kuba-kedzior/Rocketry-GPS-Tracker/Hardware/SCH_Schematic1_1-P1_2026-02-14.png

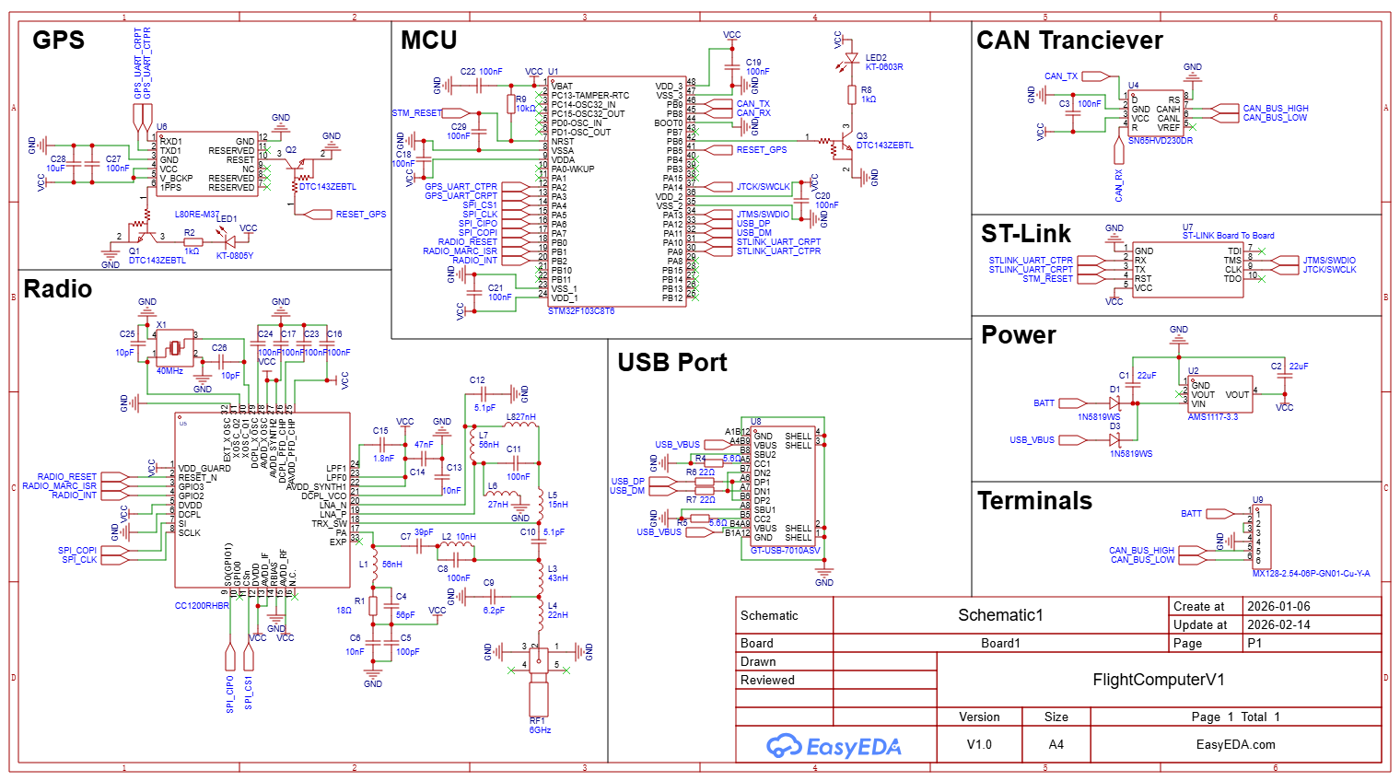
Hardware/SCH_Schematic1_1-P1_2026-02-14.png
