kuba-kedzior/Rocketry-GPS-Tracker/Hardware/BOM_Board1_PCB1_2026-04-08.csv

No. | Quantity | Comment | Designator | Footprint | Value | Manufacturer Part | Manufacturer | Supplier Part | Supplier | Primary Category | Secondary Category | JLCPCB Price | JLCPCB Stock | Name | Device
1 | 3 | 22uF | C1,C2,C30 | C0805 | 22uF | CL21A226MAQNNNE | SAMSUNG(三星) | C45783 | LCSC | Capacitors | Multilayer Ceramic Capacitors MLCC - SMD/SMT |  |  | 22uF | CL21A226MAQNNNE
2 | 10 | 100nF | C3,C18,C19,C20,C21,C22,C27,C29,C31,C32 | C0402 | 100nF | TCC0402X5R104M250AT | CCTC(三环) | C359190 | LCSC |  |  |  |  | 100nF | TCC0402X5R104M250AT
3 | 3 | 10uF | C28,C33,C34 | C0603 | 10uF | CL10A106MQ8NNNC | SAMSUNG(三星) | C1691 | LCSC |  |  |  |  | 10uF | CL10A106MQ8NNNC
4 | 2 | 1N5819WS | D1,D3 | SOD-323_L1.8-W1.3-LS2.5-RD |  | 1N5819WS | Hottech(合科泰) | C191023 | LCSC | Diodes | Schottky Diodes |  |  | 1N5819WS | 1N5819WS_C191023
5 | 1 | KT-0805Y | LED1 | LED0805-R-RD |  | KT-0805Y | KENTO | C2296 | LCSC | Optoelectronics | LED Indication - Discrete |  |  | KT-0805Y | KT-0805Y
6 | 1 | KT-0603R | LED2 | LED0603-RD |  | KT-0603R | KENTO | C2286 | LCSC | Optoelectronics | LED Indication - Discrete |  |  | KT-0603R | KT-0603R
7 | 1 | DTC143ZEBTL | Q1 | SC-89-3_L1.6-W0.9-P1.00-LS1.6-BR |  | DTC143ZEBTL | ROHM(罗姆) | C308696 | LCSC | Transistors/Thyristors | Digital Transistors |  |  | DTC143ZEBTL | DTC143ZEBTL
8 | 2 | 1kΩ | R2,R8 | R1206 | 1kΩ | 1206W4J0102T5E | UNI-ROYAL(厚声) | C1469 | LCSC |  |  |  |  | 1kΩ | 1206W4J0102T5E_C1469
9 | 2 | 5.1kΩ | R4,R5 | R0603 | 5.1kΩ | 0603WAF5101T5E | UNI-ROYAL(厚声) | C23186 | LCSC |  |  |  |  |  | 0603WAF5101T5E
10 | 2 | 22Ω | R6,R7 | R0603 | 22Ω | 0603WAJ0220T5E | UNI-ROYAL(厚声) | C1203 | LCSC |  |  |  |  | 22Ω | 0603WAJ0220T5E
11 | 1 | 10kΩ | R9 | R0402 | 10kΩ | 0402WGF1002TCE | UNI-ROYAL(厚声) | C25744 | LCSC |  |  |  |  | 10kΩ | 0402WGF1002TCE
12 | 1 | 6GHz | RF1 | SMA-SMD_HYCW12-SMAW0863-1365B | 6GHz | HYCW12-SMAW0863-1365B | 华宇创 | C5301850 | LCSC | Connectors | Coaxial Connectors (RF) |  |  | 6GHz | HYCW12-SMAW0863-1365B
13 | 1 | STM32F103C8T6 | U1 | LQFP-48_L7.0-W7.0-P0.50-LS9.0-BL |  | STM32F103C8T6 | ST(意法半导体) | C8734 | LCSC | Embedded Processors & Controllers | Microcontrollers (MCU/MPU/SOC) |  |  | STM32F103C8T6 | STM32F103C8T6
14 | 1 | AMS1117-3.3 | U2 | SOT-223-3_L6.5-W3.4-P2.30-LS7.0-BR |  | AMS1117-3.3 | AMS | C6186 | LCSC | Power Management (PMIC) | Voltage Regulators - Linear, Low Drop Out (LDO) Regulators |  |  | AMS1117-3.3 | AMS1117-3.3_C6186
15 | 1 | SN65HVD230DR | U4 | SOIC-8_L4.9-W3.9-P1.27-LS6.0-BL |  | SN65HVD230DR | TI(德州仪器) | C12084 | LCSC | Interface | CAN Transceivers |  |  | SN65HVD230DR | SN65HVD230DR
16 | 1 | L80RE-M37 | U6 | GPSM-SMD_12P-L16.0-W16.0-P2.54-BL |  | L80RE-M37 | Quectel(移远) | C3029061 | LCSC | IoT/Communication Modules | GNSS Modules |  |  | L80RE-M37 | L80RE-M37
17 | 1 | ST-LINK Board To Board | U7 | ST-LINK BOARD TO BOARD |  |  |  |  |  |  |  |  |  | ST-LINK Board To Board | ST-LINK Board To Board
18 | 1 | GT-USB-7010ASV | U8 | USB-C-SMD_G-SWITCH_GT-USB-7010ASV |  | GT-USB-7010ASV | G-Switch(品赞) | C2988369 | LCSC | Connectors | USB Connectors |  |  | GT-USB-7010ASV | GT-USB-7010ASV
19 | 1 | MX128-2.54-06P-GN01-Cu-Y-A | U9 | CONN-TH_6P-P2.54_MX128-2.54-6P |  | MX128-2.54-06P-GN01-Cu-Y-A | MAX(迈旭) | C5188446 | LCSC | Connectors | Screw Terminal Blocks |  |  | MX128-2.54-06P-GN01-Cu-Y-A | MX128-2.54-06P-GN01-Cu-Y-A
20 | 1 | lora1268F30-mini-433 | U10 | WIRELM-SMD_20P-L26.3-W16.0-P2.00_1 |  | lora1268F30-mini-433 | G-NiceRF(思为无线) | C5356645 | LCSC | IoT/Communication Modules | LoRa Modules |  |  | lora1268F30-mini-433 | lora1268F30-mini-433
