kuba-kedzior/Rocketry-GPS-Tracker/Hardware/BOM_Board1_Schematic1_2026-02-14.csv

No. | Quantity | Comment | Designator | Footprint | Value | Manufacturer Part | Manufacturer | Supplier Part | Supplier | Primary Category | Secondary Category | JLCPCB Price
1 | 2 | 22uF | C1,C2 | C0805 | 22uF | CL21A226MAQNNNE | SAMSUNG(三星) | C45783 | LCSC | Capacitors | Multilayer Ceramic Capacitors MLCC - SMD/SMT | 0.0039
2 | 14 | 100nF | C3,C8,C11,C16,C17,C18,C19,C20,C21,C22,C23,C24,C27,C29 | C0402 | 100nF | TCC0402X5R104M250AT | CCTC(三环) | C359190 | LCSC |  |  | 0.0002
3 | 1 | 56pF | C4 | C0402 | 56pF | TCC0402COG560J500AT | CCTC(三环) | C696894 | LCSC |  |  | 0.0002
4 | 1 | 100pF | C5 | C0402 | 100pF | TCC0402COG101K500AT | CCTC(三环) | C696853 | LCSC |  |  | 0.0002
5 | 2 | 10nF | C6,C13 | C0402 | 10nF | TCC0402X7R103M500AT | CCTC(三环) | C696856 | LCSC |  |  | 0.0002
6 | 1 | 39pF | C7 | C0402 | 39pF | TCC0402COG390J500AT | CCTC(三环) | C696912 | LCSC |  |  | 0.0002
7 | 1 | 6.2pF | C9 | C0402 | 6.2pF | 0402CG6R2C500NT | FH(风华) | C41744 | LCSC |  |  | 0.0002
8 | 2 | 5.1pF | C10,C12 | C0402 | 5.1pF | 0402CG5R1C500NT | FH(风华) | C60220 | LCSC |  |  | 0.0002
9 | 1 | 47nF | C14 | C0402 | 47nF | TCC0402X5R473M250AT | CCTC(三环) | C696864 | LCSC |  |  | 0.0002
10 | 1 | 1.8nF | C15 | C0402 | 1.8nF | TCC0402X7R182K500AT | CCTC(三环) | C696873 | LCSC |  |  | 0.0002
11 | 2 | 10pF | C25,C26 | C0402 | 10pF | TCC0402COG100K500AT | CCTC(三环) | C713505 | LCSC |  |  | 0.0002
12 | 1 | 10uF | C28 | C0603 | 10uF | CL10A106MQ8NNNC | SAMSUNG(三星) | C1691 | LCSC |  |  | 0.0008
13 | 2 | 1N5819WS | D1,D3 | SOD-323_L1.8-W1.3-LS2.5-RD |  | 1N5819WS | Hottech(合科泰) | C191023 | LCSC | Diodes | Schottky Diodes | 0.0013
14 | 2 | 56nH | L1,L7 | L0402-R-RD | 56nH | MLG1005S56NJT000 | TDK | C76777 | LCSC |  |  | 0.0012
15 | 1 | 10nH | L2 | L0402 | 10nH | VHF100505H10NJT | FH(风华) | C90140 | LCSC |  |  | 0.0005
16 | 1 | 43nH | L3 | L0402 | 43nH | VHF100505HQ43NJT | FH(风华) | C395067 | LCSC |  |  | 0.0006
17 | 1 | 22nH | L4 | L0402 | 22nH | VHF100505HQ22NJT | FH(风华) | C395059 | LCSC |  |  | 0.0006
18 | 1 | 15nH | L5 | L0402-RD | 15nH | VHF100505H15NKT | FH(风华) | C381880 | LCSC |  |  | 0.0006
19 | 2 | 27nH | L6,L8 | L0402-RD | 27nH | LQG15HS27NJ02D | muRata(村田) | C12669 | LCSC |  |  | 0.001
20 | 1 | KT-0805Y | LED1 | LED0805-R-RD |  | KT-0805Y | KENTO | C2296 | LCSC | Optoelectronics | LED Indication - Discrete | 0.0022
21 | 1 | KT-0603R | LED2 | LED0603-RD |  | KT-0603R | KENTO | C2286 | LCSC | Optoelectronics | LED Indication - Discrete | 0.001
22 | 3 | DTC143ZEBTL | Q1,Q2,Q3 | SC-89-3_L1.6-W0.9-P1.00-LS1.6-BR |  | DTC143ZEBTL | ROHM(罗姆) | C308696 | LCSC | Transistors/Thyristors | Digital Transistors | 0.0049
23 | 1 | 18Ω | R1 | R0805 | 18Ω | 0805W8F180JT5E | UNI-ROYAL(厚声) | C17507 | LCSC |  |  | 0.0004
24 | 2 | 1kΩ | R2,R8 | R1206 | 1kΩ | 1206W4J0102T5E | UNI-ROYAL(厚声) | C1469 | LCSC |  |  | 0.0005
25 | 2 | 5.6Ω | R4,R5 | R1206 | 5.6Ω | RTT065R60FTP | RALEC(旺诠) | C4516 | LCSC |  |  | 0.0009
26 | 2 | 22Ω | R6,R7 | R0603 | 22Ω | 0603WAJ0220T5E | UNI-ROYAL(厚声) | C1203 | LCSC |  |  | 0.0002
27 | 1 | 10kΩ | R9 | R0402 | 10kΩ | 0402WGF1002TCE | UNI-ROYAL(厚声) | C25744 | LCSC |  |  | 0.0002
28 | 1 | 6GHz | RF1 | SMA-SMD_HYCW12-SMAW0863-1365B | 6GHz | HYCW12-SMAW0863-1365B | 华宇创 | C5301850 | LCSC | Connectors | Coaxial Connectors (RF) | 0.0423
29 | 1 | STM32F103C8T6 | U1 | LQFP-48_L7.0-W7.0-P0.50-LS9.0-BL |  | STM32F103C8T6 | ST(意法半导体) | C8734 | LCSC | Embedded Processors & Controllers | Microcontrollers (MCU/MPU/SOC) | 0.1858
30 | 1 | AMS1117-3.3 | U2 | SOT-223-3_L6.5-W3.4-P2.30-LS7.0-BR |  | AMS1117-3.3 | AMS | C6186 | LCSC | Power Management (PMIC) | Voltage Regulators - Linear, Low Drop Out (LDO) Regulators | 0.0288
31 | 1 | SN65HVD230DR | U4 | SOIC-8_L4.9-W3.9-P1.27-LS6.0-BL |  | SN65HVD230DR | TI(德州仪器) | C12084 | LCSC | Interface | CAN Transceivers | 0.0835
32 | 1 | CC1200RHBR | U5 | VQFN-32_L5.0-W5.0-P0.50-TL-EP | 164 ~ 190 MHz, 410 ~ 475 MHz, 820 ~ 950 MHz | CC1200RHBR | TI(德州仪器) | C122881 | LCSC | RF and Wireless | RF Transceiver ICs | 0.4236
33 | 1 | L80RE-M37 | U6 | GPSM-SMD_12P-L16.0-W16.0-P2.54-BL |  | L80RE-M37 | Quectel(移远) | C3029061 | LCSC | IoT/Communication Modules | GNSS Modules | 1.0387
34 | 1 | ST-LINK Board To Board | U7 | ST-LINK BOARD TO BOARD
35 | 1 | GT-USB-7010ASV | U8 | USB-C-SMD_G-SWITCH_GT-USB-7010ASV |  | GT-USB-7010ASV | G-Switch(品赞) | C2988369 | LCSC | Connectors | USB Connectors | 0.0124
36 | 1 | MX128-2.54-06P-GN01-Cu-Y-A | U9 | CONN-TH_6P-P2.54_MX128-2.54-6P |  | MX128-2.54-06P-GN01-Cu-Y-A | MAX(迈旭) | C5188446 | LCSC | Connectors | Screw Terminal Blocks | 0.0819
37 | 1 | 40MHz | X1 | CRYSTAL-SMD_4P-L2.0-W1.6-BL | 40MHz | Q22FA12800101 | EPSON(爱普生) | C255898 | LCSC | Crystals, Oscillators, Resonators | Crystals | 0.04
