kuba-kedzior/Rocketry-GPS-Tracker/Hardware/SCH_Schematic1_2026-02-14.pdf

GPS | MCU

# CAN Tranciever

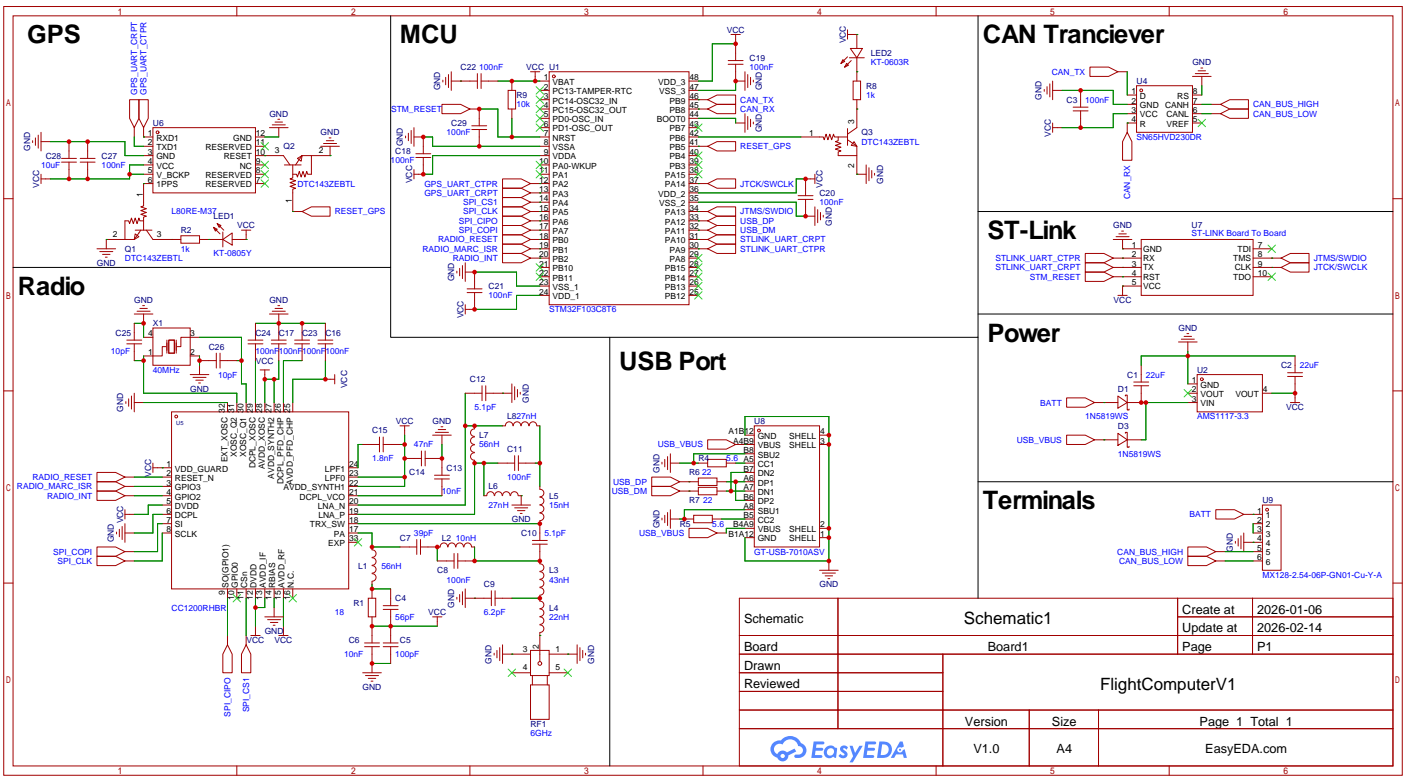
[picture p2: page 1]

ST-LINK Board To Board

GND
PA 17 TRX_SW 18 LNA_P 19 LNA_N 20 DCPL_VCO 21 AVDD_SYNTH1 22 LPF0 23 LPF1 24 AVDD_PFD_CHP ²⁵ DCPL_PFD_CHP ²⁶ AVDD_SYNTH² ²⁷ AVDD_XOSC ²⁸ DCPL_XOSC ²⁹ XOSC_Q¹ ³⁰ XOSC_Q² ³¹ EXT_XOSC ³²

SHELL 1 GND B1A12 VBUS B4A9 CC2 B5 SBU1 A8 DP2 B6 DN1 A7 DP1 A6 DN2 B7 CC1 A5 SBU2 B8 VBUS A4B9 GND A1B12

Schematic | Schematic1 | Create at | 2026-01-06

Update at | 2026-02-14

Board | Board1 | Page | P1
Drawn | | FlightComputerV1
Reviewed

Version | Size | Page 1 Total 1
V1.0 | A4 | EasyEDA.com
