kuba-kedzior/Rocketry-GPS-Tracker/(list of files, drawings)

Other design files:
Hardware/ProPrj_FlightComputerV1_2026-02-14.epro
