kuba-kedzior/Rocketry-GPS-Tracker/(commit log)

2026-02-15 Added Schematic Pre-Schematic-Review
    [BOM_Board1_Schematic1_2026-02-14.csv, ProPrj_FlightComputerV1_2026-02-14.epro]
2026-04-11 first layout iteration done
    [BOM_Board1_PCB1_2026-04-08.csv, BOM_Board1_Schematic1_2026-04-08.csv, PickAndPlace_PCB1_2026-04-08.xlsx]
